knspektrum/putrain-pcb/ESP32-S3-DEVKITC-1-N8R8.step

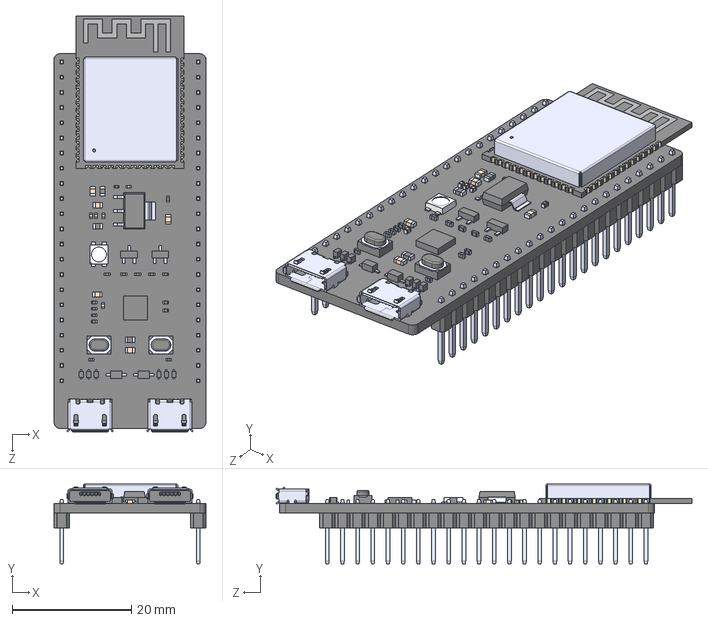
[picture p1: CAD file, 2026-03-31]
ESP32-S3-DEVKITC-1-N8R8.step
25.4 x 13.4 x 69.6 mm
