knspektrum/putrain-pcb/put_train/put_train.kicad_pcb

## KiCad design put_train/put_train.kicad_pcb (2026-04-29)

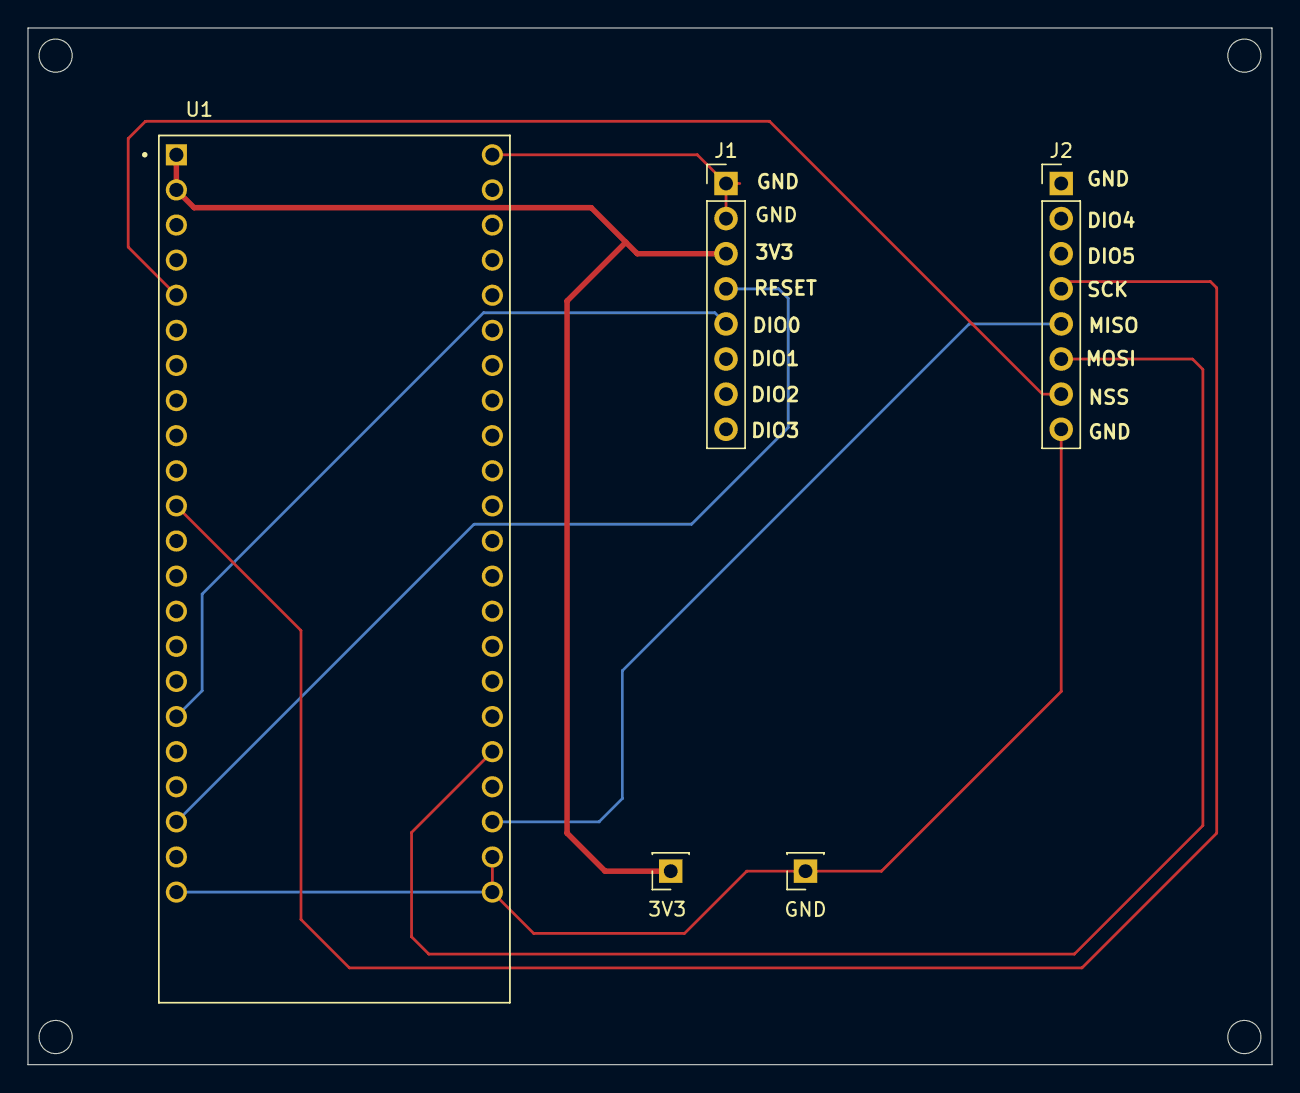
[picture p2: board put_train.kicad_pcb from above]

Board: 2 copper layers, 90.0 x 75.0 mm, 5 parts (0 on the bottom side), 8 nets.

Parts:
GND: Conn_01x01_Socket; PinSocket_1x01_P2.54mm_Vertical
J1, J2: Conn_01x08_Pin; PinHeader_1x08_P2.54mm_Vertical
J3: Conn_01x01_Socket; PinSocket_1x01_P2.54mm_Vertical
U1: ESP32-S3-DEVKITC-1-N8R8

Connections:
/3V3: J1.3 (3V3), J3.1 (Pin_1_1), U1.J1_1 (3V3), U1.J1_2 (3V3.)
unnamed: J1.5 (DIO0), U1.J1_17 (GPIO11)
unnamed: J1.4 (RESET), U1.J1_20 (GPIO14)
unnamed: J2.5 (MISO), U1.J3_20 (USB_D-/GPIO19)
unnamed: J2.6 (MOSI), U1.J3_18 (GPIO21)
unnamed: J2.7 (NSS), U1.J1_5 (GPIO5)
unnamed: J2.4 (SCK), U1.J1_11 (GPIO18)
unnamed: GND.1 (Pin_1_1), J1.1 (GND), J1.2 (GND), J2.8 (GND), U1.J1_22 (GND3), U1.J3_1 (GND), U1.J3_21 (GND1), U1.J3_22 (GND2)
