knspektrum/putrain-pcb/PUTrain/PUTrain_repeater/PUTrain_repeater.kicad_pcb

## KiCad design PUTrain/PUTrain_repeater/PUTrain_repeater.kicad_pcb (2026-03-31)

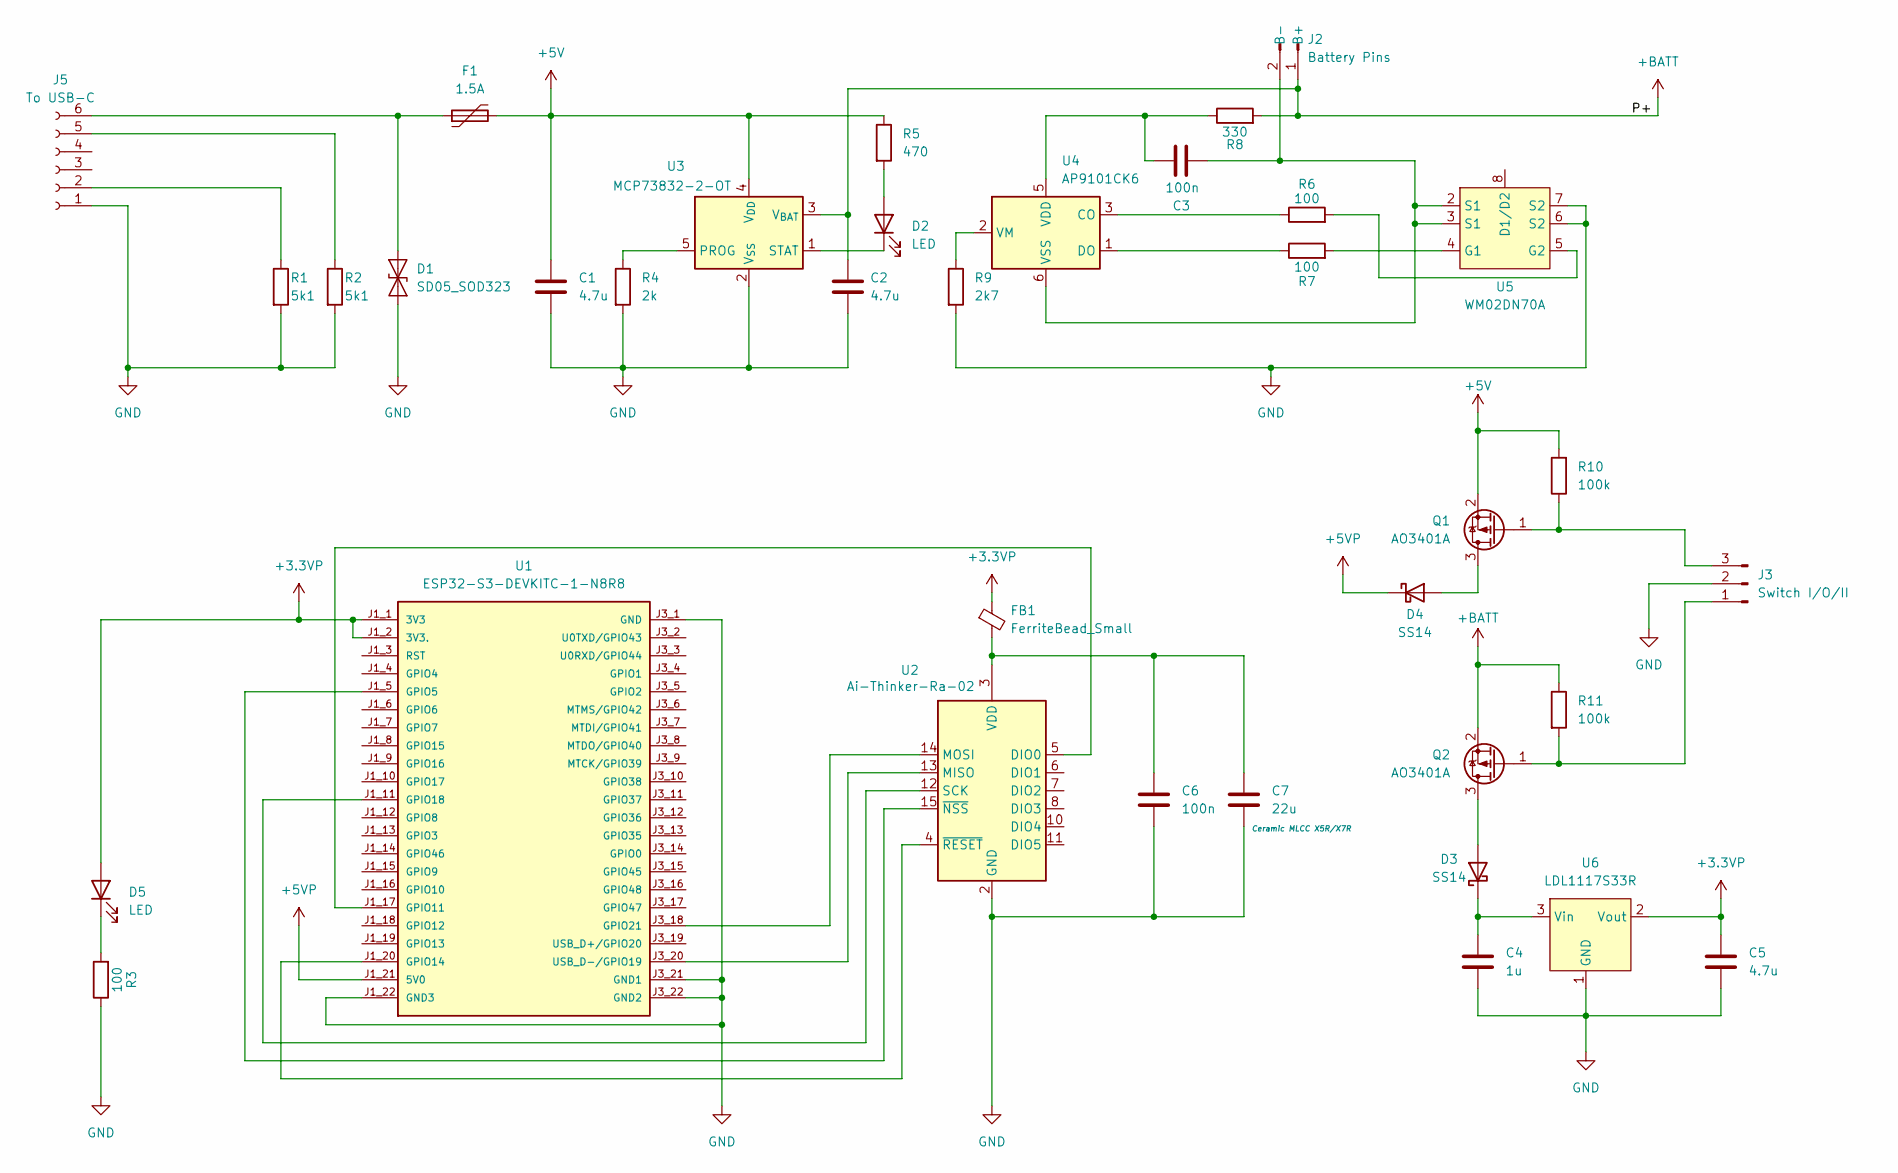
[picture p3: schematic PUTrain_repeater.kicad_sch]

Parts:
C1, C2, C5: 4.7u; C_1206_3216Metric_Pad1.33x1.80mm_HandSolder
C3, C6: 100n; C_0805_2012Metric_Pad1.18x1.45mm_HandSolder
C4: 1u; C_0805_2012Metric_Pad1.18x1.45mm_HandSolder
C7: 22u; C_1210_3225Metric_Pad1.33x2.70mm_HandSolder
D1: SD05_SOD323; D_SOD-323
D2, D5: LED; LED_D1.8mm_W1.8mm_H2.4mm_Horizontal_O1.27mm_Z8.2mm
D3, D4: SS14; D_SMA
F1: 1.5A; Fuse_1812_4532Metric_Pad1.30x3.40mm_HandSolder
FB1: FerriteBead_Small; C_0603_1608Metric_Pad1.08x0.95mm_HandSolder
J2: Battery Pins; SolderWire-0.75sqmm_1x02_P4.8mm_D1.25mm_OD2.3mm
J3: Switch I/O/II; SolderWire-0.75sqmm_1x03_P4.8mm_D1.25mm_OD2.3mm
J5: To USB-C; JST_PH_B6B-PH-K_1x06_P2.00mm_Vertical
Q1, Q2: AO3401A; SOT-23
R1, R2: 5k1; R_0603_1608Metric_Pad0.98x0.95mm_HandSolder
R3, R6, R7: 100; R_0805_2012Metric_Pad1.20x1.40mm_HandSolder
R4: 2k; R_0805_2012Metric_Pad1.20x1.40mm_HandSolder
R5: 470; R_0805_2012Metric_Pad1.20x1.40mm_HandSolder
R8: 330; R_0805_2012Metric_Pad1.20x1.40mm_HandSolder
R9: 2k7; R_0603_1608Metric_Pad0.98x0.95mm_HandSolder
R10, R11: 100k; R_0805_2012Metric_Pad1.20x1.40mm_HandSolder
U1: ESP32-S3-DEVKITC-1-N8R8
U2: Ai-Thinker-Ra-02; Ai-Thinker-Ra-01-LoRa
U3: MCP73832-2-OT; SOT-23-5
U4: AP9101CK6; SOT-23-6
U5: WM02DN70A; TSSOP-8_4.4x3mm_P0.65mm
U6: LDL1117S33R; SOT-223

Connections:
+3.3VP: C5.1, D5.2 (A), FB1.1, U1.J1_1 (3V3), U1.J1_2 (3V3.), U6.2 (Vout), U6.4 (Vout)
+5V: C1.1, F1.2, Q1.2 (S), R5.1, R10.2, U3.4 (V_{DD})
+5VP: D4.1 (K), U1.J1_21 (5V0)
+BATT: C2.1, J2.1 (B+), Q2.2 (S), R8.2, R11.1, U3.3 (V_{BAT})
GND: C1.2, C2.2, C4.2, C5.2, C6.2, C7.2, D1.1 (A1), J3.2, J5.1, R1.2, R2.2, R3.1, R4.2, R9.2, U1.J1_22 (GND3), U1.J3_1 (GND), U1.J3_21 (GND1), U1.J3_22 (GND2), U2.1 (GND), U2.2 (GND), U2.9 (GND), U2.16 (GND), U3.2 (V_{SS}), U5.6 (S2), U5.7 (S2), U6.1 (GND)
unnamed: D1.2 (A2), F1.1, J5.6
unnamed: D2.2 (A), R5.2
unnamed: D2.1 (K), U3.1 (STAT)
unnamed: D3.2 (A), Q2.3 (D)
unnamed: C4.1, D3.1 (K), U6.3 (Vin)
unnamed: D4.2 (A), Q1.3 (D)
unnamed: D5.1 (K), R3.2
unnamed: C3.1, J2.2 (B-), U4.6 (VSS), U5.2 (S1), U5.3 (S1)
unnamed: J3.1, Q2.1 (G), R11.2
unnamed: J3.3, Q1.1 (G), R10.1
unnamed: J5.2, R1.1
unnamed: J5.5, R2.1
unnamed: U1.J1_5 (GPIO5), U2.15 (~NSS)
unnamed: U1.J1_17 (GPIO11), U2.5 (DIO0)
unnamed: U1.J1_20 (GPIO14), U2.4 (~RESET)
unnamed: U1.J1_11 (GPIO18), U2.12 (SCK)
unnamed: U1.J3_18 (GPIO21), U2.14 (MOSI)
unnamed: U1.J3_20 (USB_D-/GPIO19), U2.13 (MISO)
unnamed: C6.1, C7.1, FB1.2, U2.3 (VDD)
unnamed: R4.1, U3.5 (PROG)
unnamed: R6.1, U4.3 (CO)
unnamed: R7.1, U4.1 (DO)
unnamed: C3.2, R8.1, U4.5 (VDD)
unnamed: R9.1, U4.2 (VM)
unnamed: U5.1 (D1/D2), U5.8 (D1/D2)
unnamed: R7.2, U5.4 (G1)
unnamed: R6.2, U5.5 (G2)

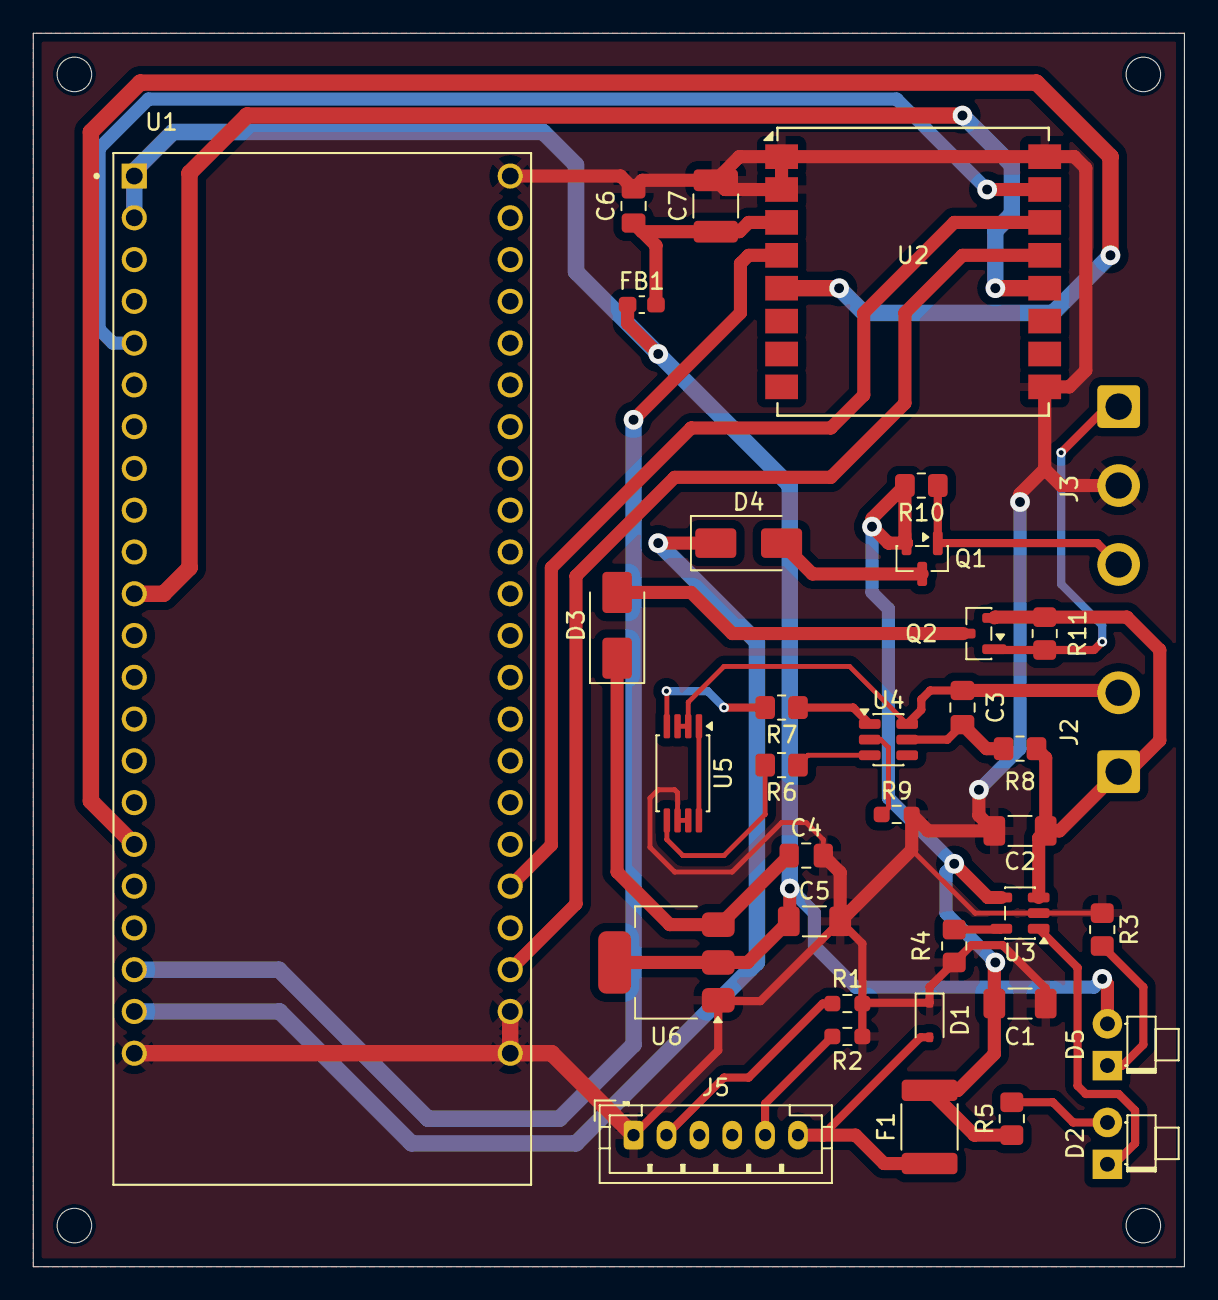
[picture p4: board PUTrain_repeater.kicad_pcb from above]

Board: 2 copper layers, 70.0 x 75.0 mm, 36 parts (0 on the bottom side), 32 nets.
