knspektrum/putrain-pcb/PUTrain/PUTrain.kicad_pcb

## KiCad design PUTrain/PUTrain.kicad_pcb (2026-03-31)

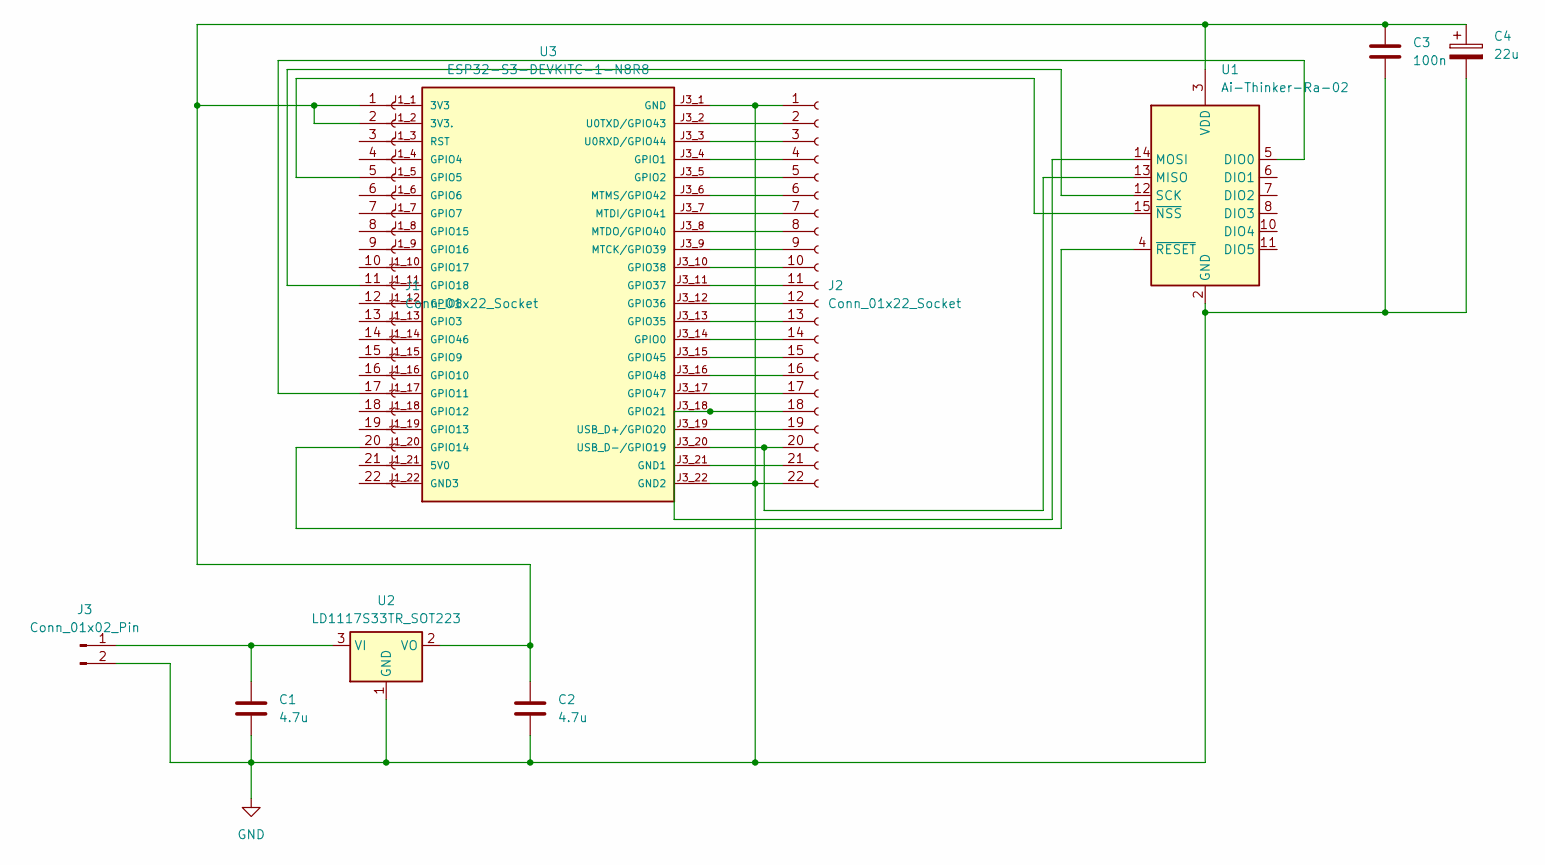
[picture p5: schematic PUTrain.kicad_sch]

Parts:
C1, C2: 4.7u; C_0805_2012Metric
C3: 100n; C_0402_1005Metric
C4: 22u; C_1206_3216Metric
J1, J2: Conn_01x22_Socket; PinSocket_1x22_P2.54mm_Vertical
J3: Conn_01x02_Pin; PhoenixContact_MSTBA_2,5_2-G_1x02_P5.00mm_Horizontal
U1: Ai-Thinker-Ra-02; Ai-Thinker-Ra-01-LoRa
U2: LD1117S33TR_SOT223; SOT-223-3_TabPin2
U3: ESP32-S3-DEVKITC-1-N8R8

Connections:
GND: C1.2, C2.2, C3.2, C4.2, J2.1, J2.21, J2.22, J3.2, U1.1 (GND), U1.2 (GND), U1.9 (GND), U1.16 (GND), U2.1 (GND), U3.J3_1 (GND), U3.J3_21 (GND1), U3.J3_22 (GND2)
unnamed: C2.1, C3.1, C4.1, J1.1, J1.2, U1.3 (VDD), U2.2 (VO)
unnamed: J1.5, U1.15 (~NSS)
unnamed: J1.11, U1.12 (SCK)
unnamed: J1.17, U1.5 (DIO0)
unnamed: J1.20, U1.4 (~RESET)
unnamed: J2.18, U1.14 (MOSI), U3.J3_18 (GPIO21)
unnamed: J2.20, U1.13 (MISO), U3.J3_20 (USB_D-/GPIO19)
unnamed: C1.1, J3.1, U2.3 (VI)
unnamed: J2.2, U3.J3_2 (U0TXD/GPIO43)
unnamed: J2.3, U3.J3_3 (U0RXD/GPIO44)
unnamed: J2.4, U3.J3_4 (GPIO1)
unnamed: J2.5, U3.J3_5 (GPIO2)
unnamed: J2.6, U3.J3_6 (MTMS/GPIO42)
unnamed: J2.7, U3.J3_7 (MTDI/GPIO41)
unnamed: J2.8, U3.J3_8 (MTDO/GPIO40)
unnamed: J2.9, U3.J3_9 (MTCK/GPIO39)
unnamed: J2.10, U3.J3_10 (GPIO38)
unnamed: J2.11, U3.J3_11 (GPIO37)
unnamed: J2.12, U3.J3_12 (GPIO36)
unnamed: J2.13, U3.J3_13 (GPIO35)
unnamed: J2.14, U3.J3_14 (GPIO0)
unnamed: J2.15, U3.J3_15 (GPIO45)
unnamed: J2.16, U3.J3_16 (GPIO48)
unnamed: J2.17, U3.J3_17 (GPIO47)
unnamed: J2.19, U3.J3_19 (USB_D+/GPIO20)

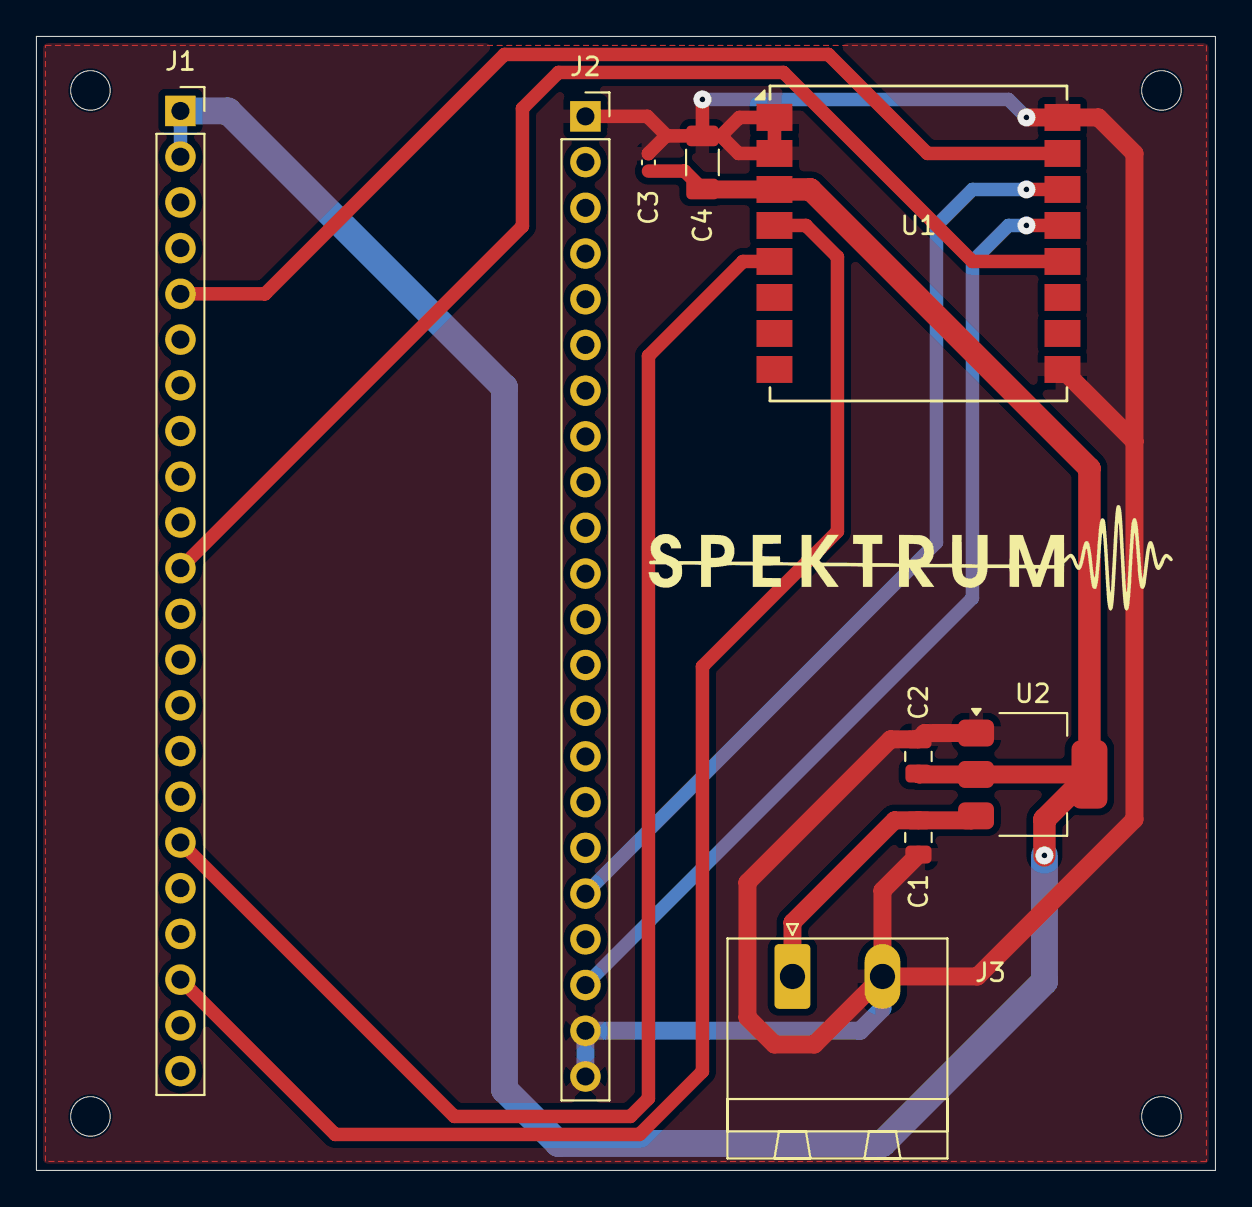
[picture p6: board PUTrain.kicad_pcb from above]

Board: 2 copper layers, 65.5 x 63.0 mm, 9 parts (0 on the bottom side), 9 nets.
