knspektrum/putrain-pcb/(commit log)

2026-03-31 Add library and PUTrain snapshot
    [ESP32-S3-DEVKITC-1-N8R8.step, PUTrain.kicad_pcb, PUTrain.kicad_sch, PUTrain_repeater.kicad_pcb, PUTrain_repeater.kicad_sch]
2026-04-29 Add put_train snapshot
    [put_train.kicad_pcb, put_train.kicad_sch]
2026-05-26 Add Wireless_Telemetry overlay
